akshattnj/vecros/BMS345-reference-x/BMS345 BoM.xlsx

Quantity | Designator | Package | Type | Value | MPFN
1 | U1 | SMD, QFN16 |  |  | BQ24650RVAR
1 | U2 | SMD, TSSOP-24 |  |  | BQ7791500PWR
2 | Q1,Q2 | SMD, SO8FL-dual | Dual NMOS |  | NVMFD5C466NLT1G
1 | D1 | SMD, 1.6x1.25mm | Bicolor LED | RED/GREEN | KPTB-1612SURKCGKC
1 | D2 | SMD, SOD-128 | Schottky |  | PMEG4050EP,115
2 | D3,D4 | SMD, SOT-23 | Schottky |  | BAT54C-7-F
1 | D5 | SMD, SOT-23 | Zener | 10V | BZX84C10LT1G
1 | L1 | SMD, 10x10mm | Shielded | 10u | SRN1060-100M
2 | R11,R16 | SMD, 2512 | 1% or better | 8m | MRF6432(2512)LR008FTS
1 | R30 | SMD, 1206 | 1% or better | 39m | STE1206M1W0R039F
1 | R12 | SMD, 1206 | 1% or better | 2R | 1206W4F200KT5E
1 | R29 | SMD, 0603 | 1% or better | 10R | 0603WAF100JT5E
2 | R15,R19 | SMD, 0603 | 1% or better | 100R | 0603WAF1000T5E
7 | R4,R5,R6,R7,R8,R9,R10 | SMD, 0603 | 1% or better | 1K | 0603WAF1001T5E
9 | R1,R3,R13,R14,R17,R18,R21,R25,R26 | SMD, 0603 | 1% or better | 10K | 0603WAF1002T5E
1 | R28 | SMD, 0603 | 1% or better | 75K | 0603WAF7502T5E
3 | R27,R33,R39 | SMD, 0603 | 1% or better | 100k | 0603WAF1003T5E
3 | R34,R35,R37 | SMD, 0603 | 1% or better | 249k | 0603WAF2493T5E
6 | R2,R20,R22,R23,R31,R32 | SMD, 0603 | 1% or better | 1M | 0603WAF1004T5E
1 | R24 | SMD, 0603 | 1% or better | 3M3 | 0603WAF3304T5E
1 | R36 | SMD, 0603 | 1% or better | 22M | RTT032205FTP
1 | C20 | SMD, 0603 | X5R and +/-20% or better, 50V+ | 18p | CC0603JRNPO9BN180
11 | C4,C5,C6,C7,C8,C9,C10,C11,C12,C15,C21 | SMD, 0603 | X5R and +/-20% or better, 50V+ | 100n | CC0603KRX7R9BB104
8 | C1,C2,C3,C13,C14,C16,C17,C19 | SMD, 0805 | X5R and +/-20% or better, 50V+ | 1u | CL21B105KBFNNNE
3 | C18,C22,C23 | SMD, 1206 | X5R and +/-20% or better, 50V+ | 10u | CL31B106KBHNNNE
1 | J1 | TH, 2.54mm pinheader | 2x5P |  | Z-21310110021001
All following components are Do Not Place (DNP):
DNP | R38 | SMD, 1206
DNP | J2 | TH, JSTXH_6P
DNP | J3 | TH, DC Jack
DNP | J4 | TH, JSTPH_3P
DNP | J5 | TH, Pinheader 1x2
DNP | Logo1 | Silkscreen logo
DNP | TP1, TP2, TP3, TP4 | Solderpad
