akshattnj/vecros/(list of files, drawings)

Other design files:
iitd 2/iitd.dsn
iitd/iitd.dsn
