akshattnj/vecros/BMS345-reference-x/BMS345.kicad_pcb

## KiCad design BMS345-reference-x/BMS345.kicad_pcb (2023-02-01)

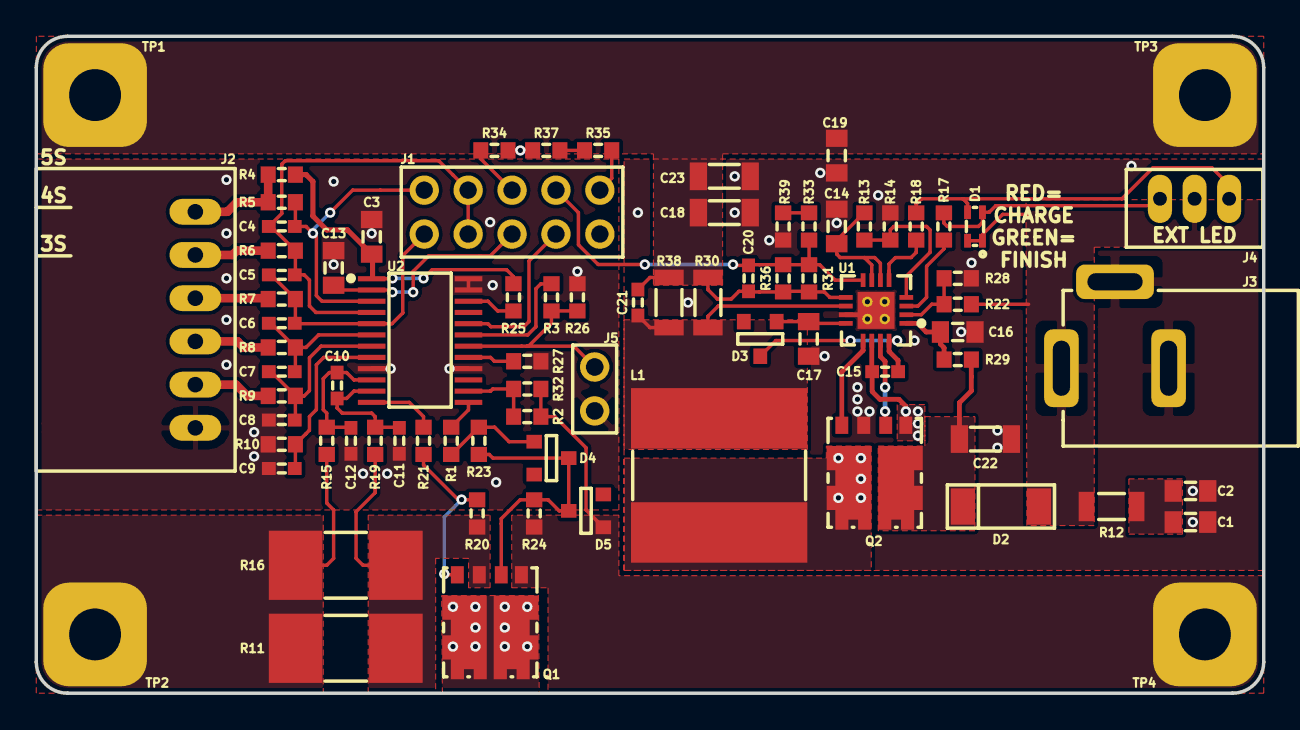
[picture p2: board BMS345.kicad_pcb from above]

Board: 2 copper layers, 71.0 x 38.0 mm, 81 parts (0 on the bottom side), 54 nets.

Parts:
C1, C2, C3, C13, C14, C16, C17, C19: 1u; C0805
C4, C5, C6, C7, C8, C9, C10, C11, C12, C15, C21: 100n; C0603
C18, C22, C23: 10u; C1206
C20: 18p; C0603
D1: RED/GREEN; KingBright_KPTB
D2: Schottky; SOD-128
D3, D4: Schottky; SOT-23Z
D5: 10V; SOT-23Z
J1: CONFIG; PinHeader_2x05_P2.54mm_Vertical
J2: BATT; JSTXH_S6B
J3: DC Jack; DC_Jack
J4: EXTLED; JSTPH_3P
J5: NTC; 2P_2.54mm_header
L1: 10u; SRN1060
Q1, Q2: NMOS; SO8FLDual
R1, R3, R17, R18, R21, R25, R26: 10k; R0603
R2, R20, R22, R23, R31, R32: 1M; R0603
R4, R5, R6, R7, R8, R9, R10: 1K; R0603
R11, R16: 8m; R2512SNS
R12: 2R; R1206
R13, R14: 10K; R0603
R15, R19: 100R; R0603
R24: 3M3; R0603
R27, R33, R39: 100k; R0603
R28: 75K; R0603
R29: 10R; R0603
R30, R38: 39m; R1206
R34, R35, R37: 249k; R0603
R36: 33M; R0603
TP1: BATT+; Pad_6mm
TP2: BATT-; Pad_6mm
TP3: PACK+; Pad_6mm
TP4: PACK-; Pad_6mm
U1: BQ24650; QFN16
U2: BQ77915; TSSOP-24

Connections:
+24V: D1.1, D1.3, D2.2, J3.1, J4.2, R12.2, R22.2
/AVDD: C13.1, J1.6, U2.2
/BATT-: R11.2, R15.1, R16.2, TP2.1
/CCFG: J1.4, U2.20
/PACK+: C18.1, C19.2, C20.1, C21.2, C23.1, R30.2, R31.2, R36.2, R38.2, TP1.1, TP3.1, U1.9
/TS: R13.1, R14.2, U1.4
/VC3: C5.2, C6.1, J1.10, R7.1, U2.5
/VC4: C4.2, C5.1, J1.7, J1.8, R6.1, U2.4
/VC5: C4.1, J1.9, R5.1, U2.3
/VFB: C20.2, J1.3, R31.1, R33.2, R36.1, U1.8
/VREF: C14.2, R13.2, U1.6, U1.7
GND: C3.2, C8.2, C9.1, C11.1, C12.2, C13.2, J1.2, J2.1, J5.2, R10.2, R26.1, R27.1, U2.9, U2.16, U2.23, U2.24
GNDPWR: C1.1, C2.1, C14.1, C16.2, C17.2, C18.2, C19.1, C22.2, C23.2, D5.2, J3.2, J3.3, Q1.5, Q2.2, R2.1, R14.1, R24.1, R28.1, R32.1, R34.2, R37.2, R39.1, TP4.1, U1.11, U1.17
unnamed: C1.2, C2.2, R12.1
unnamed: C3.1, R4.1, R25.1, U2.1
unnamed: C6.2, C7.1, R8.1, U2.6
unnamed: C7.2, C8.1, R9.1, U2.7
unnamed: C9.2, R10.1, U2.8
unnamed: C10.1, C11.2, R19.2, U2.11
unnamed: C10.2, C12.1, R15.2, U2.10
unnamed: C15.1, D3.1, U1.16
unnamed: C15.2, L1.1, Q2.4, Q2.5, U1.14
unnamed: C16.1, R29.1, U1.1
unnamed: C17.1, D3.2, U1.12
unnamed: C21.1, L1.2, R30.1, R38.1, U1.10
unnamed: C22.1, D2.1, Q2.6, R29.2
unnamed: D1.2, J4.3, R17.2
unnamed: D1.4, J4.1, R18.2
unnamed: D4.1, D5.1, Q1.1, R23.1, R24.2
unnamed: D4.2, R1.1, R23.2
unnamed: J1.1, R35.1
unnamed: J1.5, R34.1
unnamed: J2.2, R9.2
unnamed: J2.3, R8.2
unnamed: J2.4, R7.2
unnamed: J2.5, R6.2
unnamed: J2.6, R4.2, R5.2
unnamed: J5.1, R3.1, R26.2, U2.18
unnamed: Q1.2, R11.1, R16.1, R19.1, R20.1
unnamed: Q1.3, R20.2, R21.1
unnamed: Q1.4, Q1.6
unnamed: Q2.1, U1.15
unnamed: Q2.3, U1.13
unnamed: R1.2, U2.13
unnamed: R2.2, R32.2, U2.14
unnamed: R3.2, U2.19
unnamed: R17.1, U1.3
unnamed: R18.1, U1.5
unnamed: R21.2, U2.12
unnamed: R22.1, R28.2, U1.2
unnamed: R25.2, U2.22
unnamed: R27.2, U2.17
unnamed: R33.1, R39.2
unnamed: R35.2, R37.1
