akshattnj/vecros/iitd 2/iitd.kicad_pcb

## KiCad design iitd 2/iitd.kicad_pcb (2023-02-01)

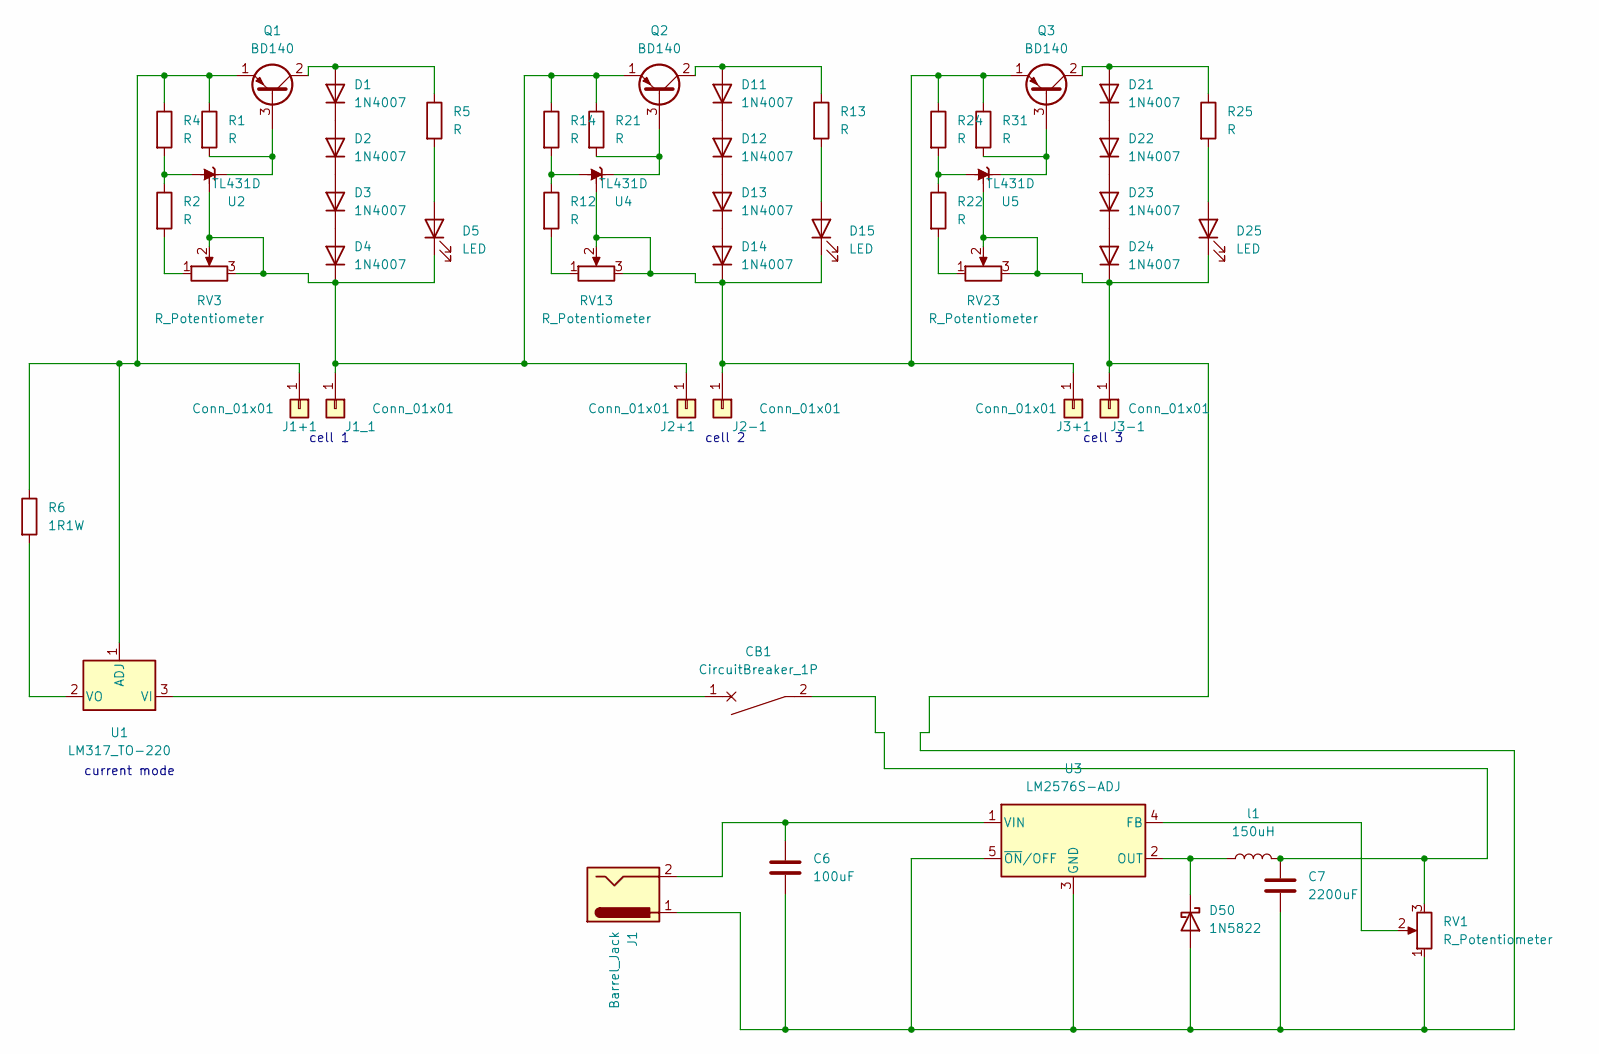
[picture p3: schematic iitd.kicad_sch]

Parts:
C6: 100uF; CP_Radial_D4.0mm_P2.00mm
C7: 2200uF; CP_Radial_D4.0mm_P2.00mm
CB1: CircuitBreaker_1P; SW_Tactile_Straight_KSL0Axx1LFTR
D1, D2, D3, D4, D11, D12, D13, D14, D21, D22, D23, D24: 1N4007; D_DO-41_SOD81_P10.16mm_Horizontal
D5, D15, D25: LED; D_5W_P10.16mm_Horizontal
D50: 1N5822; D_DO-201AD_P15.24mm_Horizontal
J1: Barrel_Jack; BarrelJack_CUI_PJ-063AH_Horizontal_CircularHoles
J1+1, J1_1, J2+1, J2-1, J3+1, J3-1: Conn_01x01; PinHeader_1x01_P1.00mm_Horizontal
Q1, Q2, Q3: BD140; TO-126-3_Vertical
R1, R4, R21: R; R_Axial_DIN0309_L9.0mm_D3.2mm_P15.24mm_Horizontal
R2, R5, R12, R13, R14, R22, R24, R25, R31: R; R_Axial_DIN0309_L9.0mm_D3.2mm_P12.70mm_Horizontal
R6: 1R1W; R_Axial_DIN0309_L9.0mm_D3.2mm_P12.70mm_Horizontal
RV1, RV3, RV13, RV23: R_Potentiometer; Potentiometer_ACP_CA14-H2,5_Horizontal
U1: LM317_TO-220; TO-220-3_Vertical
U2, U4, U5: TL431D; SOIC-8_3.9x4.9mm_P1.27mm
U3: LM2576S-ADJ; TO-263-5_TabPin3
l1: 150uH; L_Axial_L6.6mm_D2.7mm_P2.54mm_Vertical_Vishay_IM-2

Connections:
unnamed: C7.1, CB1.2, RV1.3, l1.2
unnamed: D1.1 (K), D2.2 (A)
unnamed: D1.2 (A), Q1.2 (C), R5.1
unnamed: D2.1 (K), D3.2 (A)
unnamed: D3.1 (K), D4.2 (A)
unnamed: D4.1 (K), D5.1 (K), J1_1.1, J2+1.1, Q2.1 (E), R14.1, R21.1, RV3.2, RV3.3, U2.8 (REF)
unnamed: D5.2 (A), R5.2
unnamed: D11.1 (K), D12.2 (A)
unnamed: D11.2 (A), Q2.2 (C), R13.1
unnamed: D12.1 (K), D13.2 (A)
unnamed: D13.1 (K), D14.2 (A)
unnamed: D14.1 (K), D15.1 (K), J2-1.1, J3+1.1, Q3.1 (E), R24.1, R31.1, RV13.2, RV13.3, U4.8 (REF)
unnamed: D15.2 (A), R13.2
unnamed: D21.1 (K), D22.2 (A)
unnamed: D21.2 (A), Q3.2 (C), R25.1
unnamed: D22.1 (K), D23.2 (A)
unnamed: D23.1 (K), D24.2 (A)
unnamed: C6.1, C7.2, D24.1 (K), D25.1 (K), D50.2 (A), J1.1, J3-1.1, RV1.1, RV23.2, RV23.3, U3.3 (GND), U3.5 (~ON/OFF), U5.8 (REF)
unnamed: D25.2 (A), R25.2
unnamed: D50.1 (K), U3.2 (OUT), l1.1
unnamed: J1+1.1, Q1.1 (E), R1.1, R4.1, R6.1, U1.1 (ADJ)
unnamed: C6.2, J1.2, U3.1 (VIN)
unnamed: Q1.3 (B), R1.2, U2.1 (K)
unnamed: Q2.3 (B), R21.2, U4.1 (K)
unnamed: Q3.3 (B), R31.2, U5.1 (K)
unnamed: R2.1, R4.2, U2.2 (A), U2.3 (A), U2.6 (A), U2.7 (A)
unnamed: R2.2, RV3.1
unnamed: R6.2, U1.2 (VO)
unnamed: R12.1, R14.2, U4.2 (A), U4.3 (A), U4.6 (A), U4.7 (A)
unnamed: R12.2, RV13.1
unnamed: R22.1, R24.2, U5.2 (A), U5.3 (A), U5.6 (A), U5.7 (A)
unnamed: R22.2, RV23.1
unnamed: RV1.2, U3.4 (FB)
unnamed: CB1.1, U1.3 (VI)

Notes on the sheet:
cell 2
current mode
cell 3
cell 1

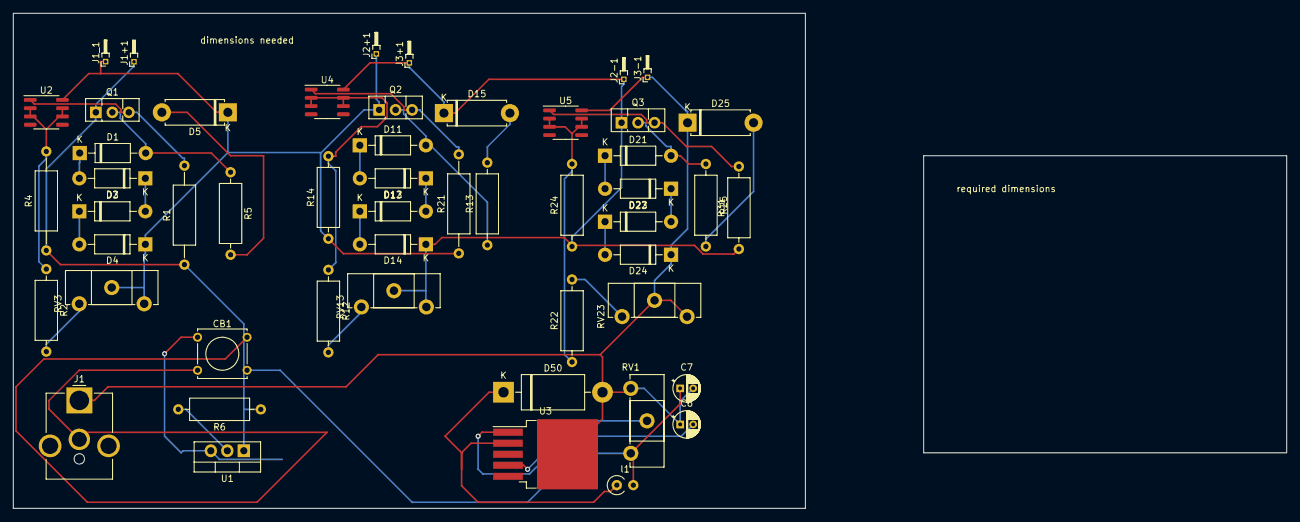
[picture p4: board iitd.kicad_pcb from above]

Board: 2 copper layers, 121.9 x 76.2 mm, 52 parts (0 on the bottom side), 34 nets.
